dnlsdn/KalebV2/docs/wiring/index.html

# KalebV2 WiringSpotMicroESP32 build · every connection on the bench and what is still to come

Bench today Robot complete

built and measuredto build before it walksafter it walks, routing not decidednot connected on purposeAWG14AWG16Dupont

+−↔

## Selected wire

## In this drawing

## Read this first

Power wires are drawn in the colours on the bench. Dupont colours are a convention for this drawing: 5V red, 3.3V violet, SDA yellow, SCL orange, signals blue, analog green. Screw positions on the bus bars are illustrative. There is no relay: the servo rail is live whenever the pack is connected, and in the complete robot the main switch turns it on and off.

status | from | to | net | wire | notes

Sources: michaelkubina/SpotMicroESP32 (https://github.com/michaelkubina/SpotMicroESP32) (BOM, Fritzing diagram) · runeharlyk/SpotMicroESP32-Leika (https://github.com/runeharlyk/SpotMicroESP32-Leika) (components, channel map). Measured values come from the session logs in main-steps/ and current-power-&-wiring-connections.md. Generated by docs/wiring/build.py and page.py.
