dnlsdn/KalebV2/main-steps/images/18-rest-pose.jpg

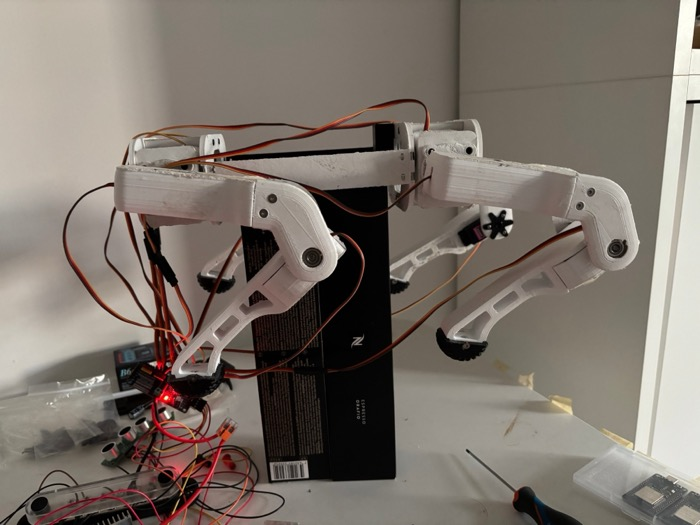
main-steps/images/18-rest-pose.jpg
