dnlsdn/KalebV2/(commit log)

2025-11-15 Update Step_1-Pre-Alignment-Servos.md adding an image
2025-11-15 Update Step_1-Wrist-Calibration-and-Assembly.md adding a photo
2025-11-28 Update and rename Step_3-XT60-positive-lead-fuse-holder-integration.md to Step_2-XT60-positive-lead-fuse-holder-integration.md
2025-12-04 Create Step_6-ESP32-Power-Integration
2025-12-04 Update and rename Step_6-ESP32-power-integration to Step_6-ESP32-power-integration.md
2025-12-21 Create Power-Up & Power-Down Procedures.md
2026-07-31 Session 2: verify the bench after the break, add STATE.md, fix relay pin and ECHO divider
2026-07-31 Add power tree and ECHO divider diagrams to session 2
2026-08-14 Session 3: choose Leika as firmware, cut optional sensors from the critical path, fix relay pin conflict
2026-08-14 Session 4: I2C bus working, PCA9685 at 0x40 and MPU6050 at 0x68, move PCA9685 to 3.3V
2026-08-14 Move test sketches into code/ as real .ino files, document the missing-firmware problem in the README
    [i2c_scanner.ino, relay_off_on_safe.ino]
2026-08-27 Session 5: build and verify the 6V servo rail, find the relay module cannot be driven at 3.3V
2026-09-19 Add wiring diagram of the bench and the complete robot
    Two SVG drawings generated from docs/wiring/wires.py, plus an interactive
    page served by GitHub Pages with gauge, net, status and measured value
    of every wire.
2026-09-19 Decide to bypass the relay and plan session 6 around it
    The relay module is a low-level-trigger PNP variant that a 3.3V pin cannot
    drive. Rather than add parts, a COM-NO jumper makes the servo rail follow
    the pack and the main switch, as in Leika, which then runs unmodified.
2026-09-19 Session 6: remove the relay, join the servo rail in a WAGO, rail follows the pack
    The relay module cannot be held open by an ESP32 pin. Its two power wires are
    now joined in a WAGO 221-412 and the module is off the bench. Measured with
    no servo: PCA9685 V+ 6.0V with the pack connected, 0V after unplugging, red
    bar unchanged at 4.98V. Power procedure rewritten: the fuse stays in and the
    XT60 is connected last. Wiring diagram updated.
2026-09-19 Session 7: first servo centred on channel 0, chain verified under load
    servo_center drives PCA9685 channel 0 to 1500us. A replacement MG996R moved
    to centre and held; V+ stayed at 6.0V and the red bar at 4.98V. Found in
    Espressif's DevKitC guide that USB and the 5V pin must never power the board
    together: the power procedure is corrected. Session 8 planned: both
    replacement servos into their legs.
    [build.py, layout.py, servo_center.ino]
2026-09-20 Session 8: shoulder joints and shoulder servos onto all four legs
    The step had never been done. servo_angle sets any joint to the angle the
    assembly guide asks for, on the Arduino Servo library's scale: hips at 120
    degrees left and 60 right, shoulders at 90. Corrects this repo's claim that
    ten servos were centred at 1500us: each joint has its own angle, and the
    wrists were set at 0 and 180 in November.
    [servo_angle.ino]
2026-09-20 Session 9: legs hung from the outer shoulders, and a print list
    Two horns per Outer Shoulder piece, a pair of legs on each, shoulder servos
    left at 90 degrees. Both pairs came out parallel and symmetric, which also
    clears the shoulder shaft direction left open in session 8. Adds
    docs/print-list.md with everything still to print, in the order it is needed.
2026-09-21 Session 10: chassis built and both leg groups on it
    Inner shoulders, chassis sides and the SZBK07 Extended mounting plate, left
    empty so the bench electronics move in only after twelve servos have run.
    Shoulders re-checked at 90 degrees. All thighs sloping to the tail is the
    design, confirmed against michaelkubina's photo. The hips moved during
    assembly and are checked first in session 11. Adds a fastener list and
    Leika's stand to the print list.
2026-09-21 Session 11: every joint checked at its mounting angle, rear right knee fixed
    All twelve servos driven one at a time to the angle they were mounted at.
    Hips that moved in session 10 corrected. The rear right knee was one horn
    arm (60 degrees) off since November and would never have closed fully; the
    horn mount was turned one arm on its M2 screws without opening the leg.
2026-09-21 Record the battery, how it is charged, and the first full charge
    Ovonic 2S 5200mAh 50C, charged on a SkyRC B6neo at 3A: 3833mAh in, 8.40V
    at the end. It was nearer a quarter full than the half its resting voltage
    suggested.
2026-09-21 Session 12: all twelve servos on their real channels
    channel_check brings every servo to its mounting angle one at a time, then
    moves one joint at a time and back. Every channel moved its own joint, none
    swapped, none buzzing; V+ 6.0V and red bar 5.0V with all twelve holding.
    Wiring map and diagram updated. Next: Leika.
    [build.py, channel_check.ino, layout.py]
2026-09-21 Session 13, first half: Leika cloned and configured for this hardware
    Records where Leika lives, the upstream commit it is based on, and the three
    changes on its local kalebv2 branch: esp32dev board, MPU6050 on and WS2812
    off, I2C at 400kHz because the MPU6050 shares the bus. STATE.md says where to
    pick up: build, flash, open the app.
2026-09-21 Session 13, computer side: Leika builds with the web app embedded
    The first build silently shipped without the app because protoc was
    missing. Document the fix, the flash-size warning to watch on first
    boot, and a desk check of what Leika sends to each servo.
2026-10-03 Session 13, bench side: Leika boots, serves its app and reads both I2C devices
    Three fixes were needed on top of the desk configuration: PSRAM off for
    esp32dev, the MPU6500's WHO_AM_I accepted, and a Leika bug that kept the
    access point from starting. Next session is servo calibration, proposed
    on a spare MG996R before touching the assembled legs.
2026-10-03 Session 14: servo conversion measured on a spare MG996R
    2.56 ticks per degree over 180 degrees, against Leika's default 2.0,
    entered for all twelve channels and recorded since it lives only in the
    ESP32's filesystem. Body frame calibration is next.
2026-10-03 Session 14 log: servo table screenshot and a diagram of the grid method
2026-10-04 Session 15: all twelve joints calibrated in the body frame
    Center PWM measured one leg at a time at knee 90 degrees and foot under
    the hip, since Leika's Calibration mode now turns the servos off. Nine of
    twelve joints were 4 degrees or more off the default. Brown-out resets
    found during the session make them the next session; STOP is recorded
    as not relaxing the servos.
2026-10-04 Session 16: an I2C race fixed in Leika, and the ESP32 lost
    The task watchdog reset traced to two tasks sharing Leika's I2C handle;
    a lock took the errors from 21 in 109 slider moves to 0 in 812. The board
    then died during a probe reading on its header. Its five wires are
    recorded by colour, the calibration is now Leika's firmware default, and
    session 17 is the replacement board.
2026-10-04 Session logs 1-12: diagrams and local photos
    Adds SVG diagrams where a session explains a concept: the session 1
    power path, the I2C bus with its WAGO junctions, the relay threshold
    that no ESP32 pin can reach, the relay bypass, the servo pulse, and
    the channel map with mounting angles (sessions 8 and 12). The four
    photos hosted as GitHub attachments now live in main-steps/images at
    web size, with captions.
2026-10-31 Session 17: a new ESP32, and no brown-out with one leg
    The replacement board was flashed on USB alone and started calibrated
    from the firmware defaults. On the bench, the 3.3V line was checked for a
    short and both red Duponts by resistance before power; the I2C page then
    listed the PCA9685 and the IMU, so both survived session 16.
    With the pack, six minutes idle and then one leg activated with its three
    servos moved one at a time: no restart, checked by converting Leika's
    Uptime against the clock. Session 18 is twelve servos together, then Rest
    with the robot lifted.
2026-10-31 Session 18: twelve servos together, the first pose, and a firmware crash
    The nine servos went back on their channels and all twelve were activated
    at once with no restart, so session 15's brown-out did not return under
    the largest load. Rest, the first pose from Leika's kinematics, works with
    the robot lifted and the four legs symmetric; Stand works too.
    The rear right knee's 42 degree bend in the straight pose is the 125
    clamp, corrected from session 15's 15 degree estimate. After the board
    stopped answering and the pack was reconnected, it read a panic reset:
    session 19 hunts it on USB with the serial monitor.
2026-10-31 Session 19: why the robot stopped answering, and core dumps on
    A serial log on USB showed the board refusing connections after the
    phone's Wi-Fi dropped: Leika kept dead clients and their sockets, and
    lwIP's 10 sockets ran out. Keep-alive, a close_fn and 16 sockets fixed it.
    The Restart button works after two more Leika bugs, the second a panic
    in sendOk() caught and decoded from the new flash core dump.
    Session 18's panic was not reproduced on USB; core dumps now keep it if
    it happens on the pack. Leika has thirteen changes. Session 20 moves the
    electronics onto the body.
2026-11-01 Session 20: the bus bars come out
    Measured from michaelkubina's STL, the plate's mounting area is about
    106 x 150mm, and each bus bar is 150 x 28mm: the two do not fit. They
    were replaced on the bench, node for node and with nothing bought:
    three chained WAGO 221-415 for ground (every heavy ground on A), a
    fourth for 5V, and 3.3V and I2C through the PCA9685's two headers,
    which are joined pin for pin on the board.
    Tracing each wire showed that neither step-down has an OUT- wire, though
    the connections file had both "Verified" on the black bar since July;
    corrected there and in the wiring drawing. Unpowered checks, a cold USB
    boot (0x40 and 0x68) and the pack (4.95V, 6.01V, Rest) all pass.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
